Roboy/myo_shield/README.md

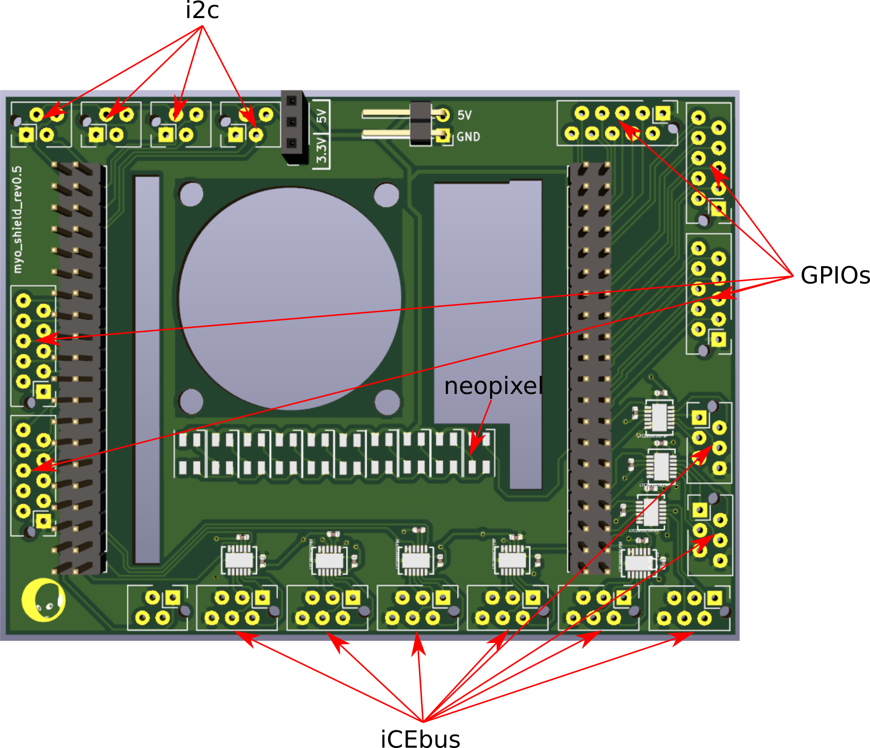
[picture p1: images/myo_shield.png]
myo_shield
