Roboy/myo_shield/myo_shield_pcb/myo_shield_pcb.kicad_pcb

## KiCad design myo_shield_pcb/myo_shield_pcb.kicad_pcb (2020-03-10)

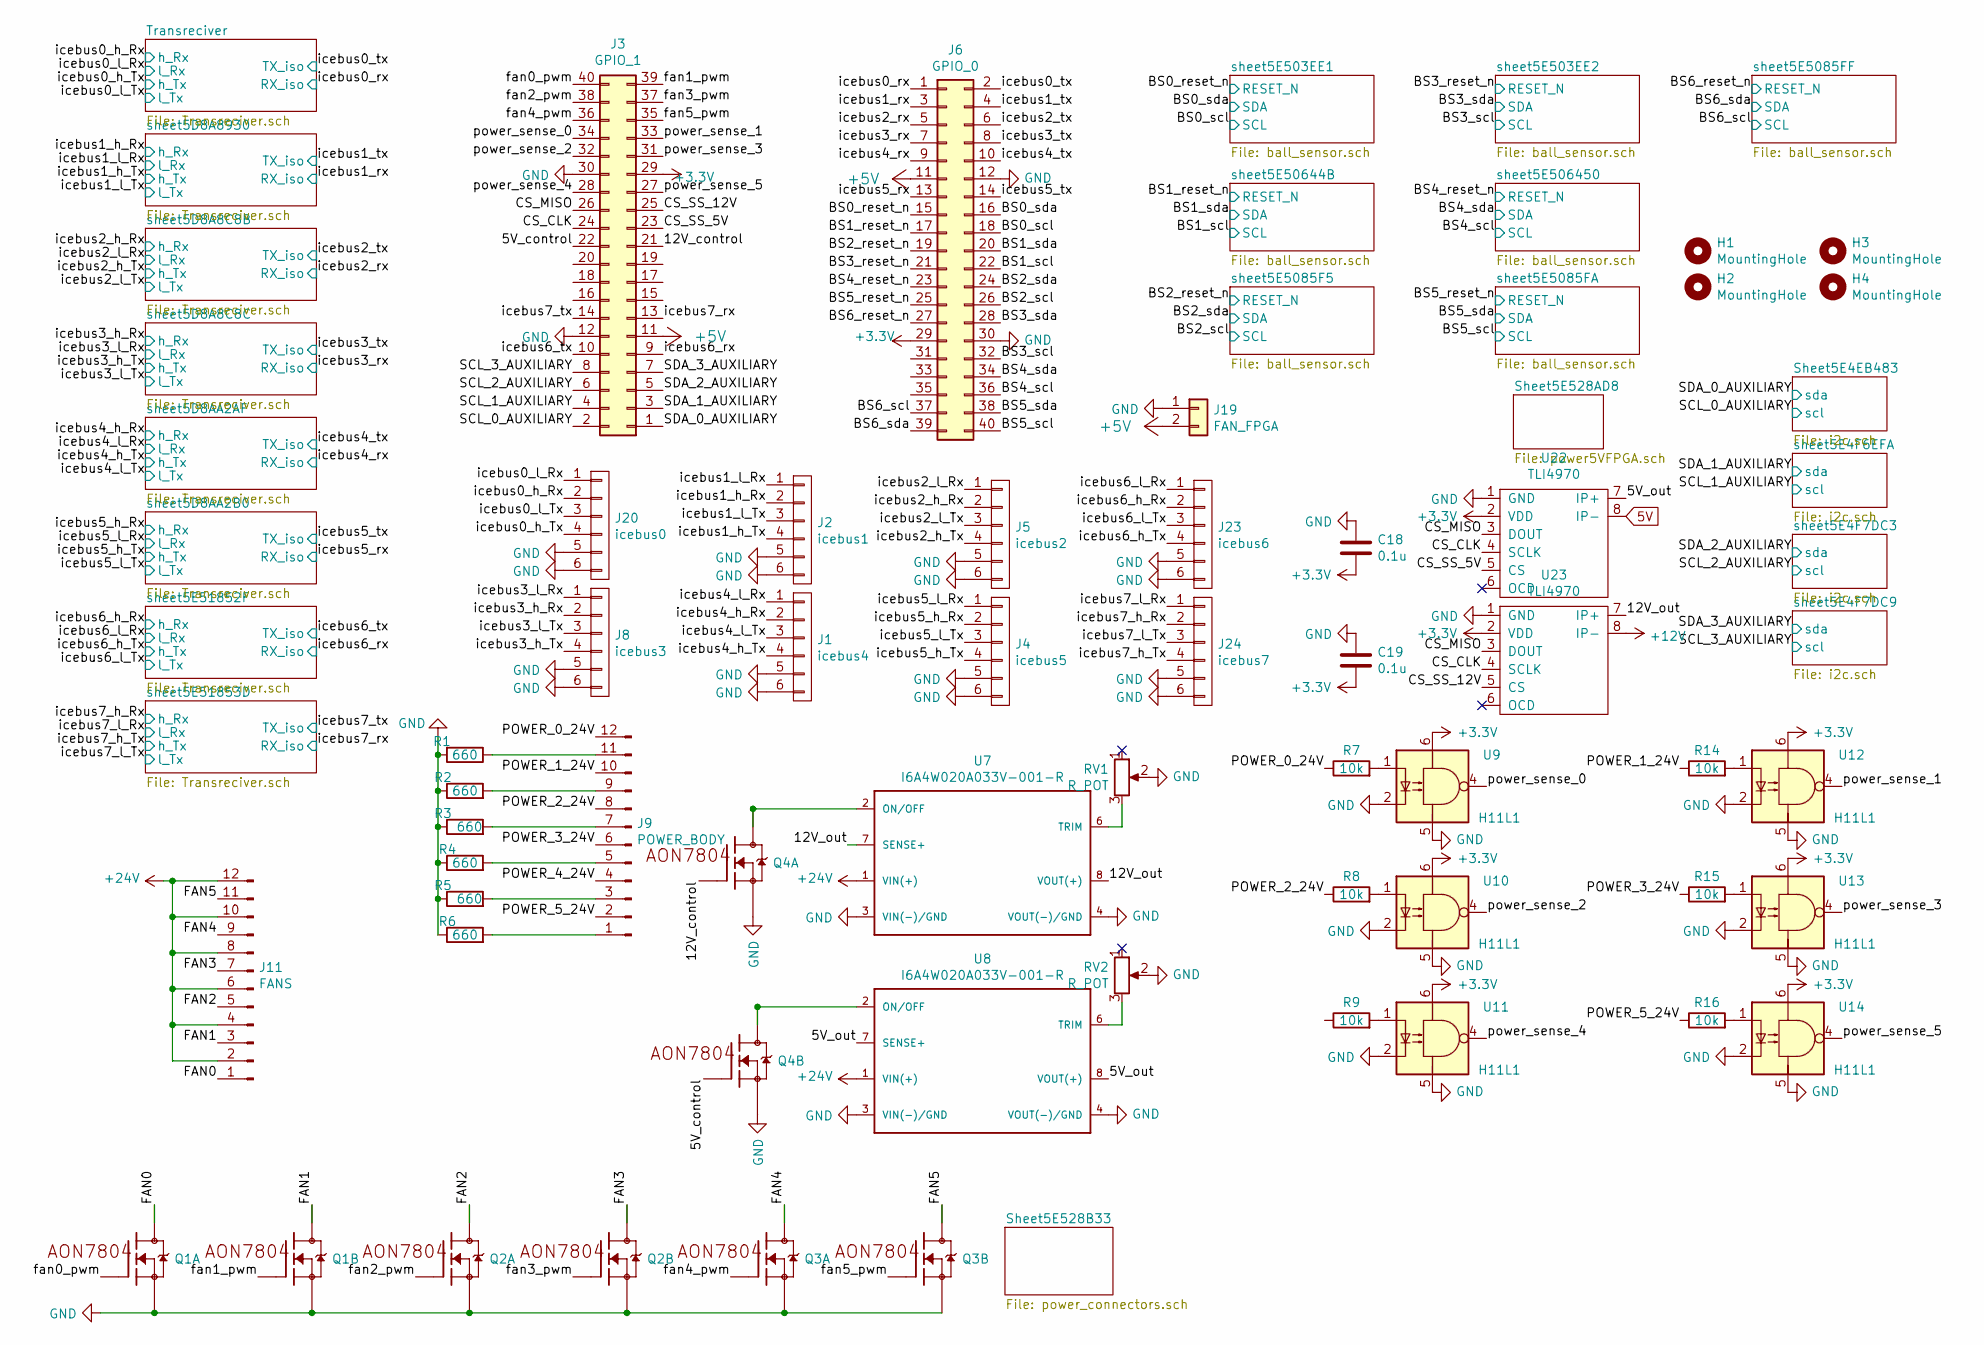
[picture p2: schematic myo_shield_pcb.sch]

Parts:
C18, C19: 0.1u; C_0402_1005Metric
H1, H2, H3, H4: MountingHole; MountingHole_3.2mm_M3
J1: icebus4; TE-Connectivity_Micro-Match_connector_02x03_Pitch_1.27mm
J2: icebus1; TE-Connectivity_Micro-Match_connector_02x03_Pitch_1.27mm
J3: GPIO_1; PinHeader_2x20_P2.54mm_Vertical
J4: icebus5; TE-Connectivity_Micro-Match_connector_02x03_Pitch_1.27mm
J5: icebus2; TE-Connectivity_Micro-Match_connector_02x03_Pitch_1.27mm
J6: GPIO_0; PinHeader_2x20_P2.54mm_Vertical
J8: icebus3; TE-Connectivity_Micro-Match_connector_02x03_Pitch_1.27mm
J9: POWER_BODY; PinHeader_2x06_P2.54mm_Vertical
J11: FANS; PinHeader_2x06_P2.54mm_Vertical
J19: FAN_FPGA; PinHeader_1x02_P2.54mm_Vertical
J20: icebus0; TE-Connectivity_Micro-Match_connector_02x03_Pitch_1.27mm
J23: icebus6; TE-Connectivity_Micro-Match_connector_02x03_Pitch_1.27mm
J24: icebus7; TE-Connectivity_Micro-Match_connector_02x03_Pitch_1.27mm
Q1, Q2, Q3, Q4: AON7804; DFN3X3
R1, R2, R3, R4, R5, R6: 660; R_0402_1005Metric
R7, R8, R9, R14, R15, R16: 10k; R_0402_1005Metric
RV1, RV2: R_POT; Potentiometer_Bourns_3214X_Vertical
U7, U8: I6A4W020A033V-001-R; TDK-LAMBDA_I6A4W020A033V-001-R
U9, U10, U11, U12, U13, U14: H11L1; DIL6-SMD
U22, U23: TLI4970

Connections:
5V: U22.8 (IP-); also elsewhere on the board
+3V3: C18.2, C19.2, J3.29, J6.29, U9.6, U10.6, U11.6, U12.6, U13.6, U14.6, U22.2 (VDD), U23.2 (VDD); also elsewhere on the board
+5V: J3.11, J6.11, J19.2; also elsewhere on the board
+12V: U23.8 (IP-); also elsewhere on the board
+24V: J11.2, J11.4, J11.6, J11.8, J11.10, J11.12, U7.1 (VIN(+)), U8.1 (VIN(+)); also elsewhere on the board
/5V_control: J3.22, Q4.G2 (G)
/5V_out: U8.7 (SENSE+), U8.8 (VOUT(+)), U22.7 (IP+)
/12V_control: J3.21, Q4.G1 (G)
/12V_out: U7.7 (SENSE+), U7.8 (VOUT(+)), U23.7 (IP+)
/BS0_reset_n: J6.15; also elsewhere on the board
/BS0_scl: J6.18; also elsewhere on the board
/BS0_sda: J6.16; also elsewhere on the board
/BS1_reset_n: J6.17; also elsewhere on the board
/BS1_scl: J6.22; also elsewhere on the board
/BS1_sda: J6.20; also elsewhere on the board
/BS2_reset_n: J6.19; also elsewhere on the board
/BS2_scl: J6.26; also elsewhere on the board
/BS2_sda: J6.24; also elsewhere on the board
/BS3_reset_n: J6.21; also elsewhere on the board
/BS3_scl: J6.32; also elsewhere on the board
/BS3_sda: J6.28; also elsewhere on the board
/BS4_reset_n: J6.23; also elsewhere on the board
/BS4_scl: J6.36; also elsewhere on the board
/BS4_sda: J6.34; also elsewhere on the board
/BS5_reset_n: J6.25; also elsewhere on the board
/BS5_scl: J6.40; also elsewhere on the board
/BS5_sda: J6.38; also elsewhere on the board
/BS6_reset_n: J6.27; also elsewhere on the board
/BS6_scl: J6.37; also elsewhere on the board
/BS6_sda: J6.39; also elsewhere on the board
/CS_CLK: J3.24, U22.4 (SCLK), U23.4 (SCLK)
/CS_MISO: J3.26, U22.3 (DOUT), U23.3 (DOUT)
/CS_SS_5V: J3.23, U22.5 (CS)
/CS_SS_12V: J3.25, U23.5 (CS)
/FAN0: J11.1, Q1.D1 (D), Q1.D1A (D1)
/FAN1: J11.3, Q1.D2 (D), Q1.D2A (D1)
/FAN2: J11.5, Q2.D1 (D), Q2.D1A (D1)
/FAN3: J11.7, Q2.D2 (D), Q2.D2A (D1)
/FAN4: J11.9, Q3.D1 (D), Q3.D1A (D1)
/FAN5: J11.11, Q3.D2 (D), Q3.D2A (D1)
/POWER_0_24V: J9.12, R7.1
/POWER_1_24V: J9.10, R14.1
/POWER_2_24V: J9.8, R8.1
/POWER_3_24V: J9.6, R15.1
/POWER_4_24V: J9.4
/POWER_5_24V: J9.2, R16.1
/SCL_0_AUXILIARY: J3.2; also elsewhere on the board
/SCL_1_AUXILIARY: J3.4; also elsewhere on the board
/SCL_2_AUXILIARY: J3.6; also elsewhere on the board
/SCL_3_AUXILIARY: J3.8; also elsewhere on the board
/SDA_0_AUXILIARY: J3.1; also elsewhere on the board
/SDA_1_AUXILIARY: J3.3; also elsewhere on the board
/SDA_2_AUXILIARY: J3.5; also elsewhere on the board
/SDA_3_AUXILIARY: J3.7; also elsewhere on the board
/fan0_pwm: J3.40, Q1.G1 (G)
/fan1_pwm: J3.39, Q1.G2 (G)
/fan2_pwm: J3.38, Q2.G1 (G)
/fan3_pwm: J3.37, Q2.G2 (G)
/fan4_pwm: J3.36, Q3.G1 (G)
/fan5_pwm: J3.35, Q3.G2 (G)
/icebus0_h_Rx: J20.2; also elsewhere on the board
/icebus0_h_Tx: J20.4; also elsewhere on the board
/icebus0_l_Rx: J20.1; also elsewhere on the board
/icebus0_l_Tx: J20.3; also elsewhere on the board
/icebus0_rx: J6.1; also elsewhere on the board
/icebus0_tx: J6.2; also elsewhere on the board
/icebus1_h_Rx: J2.2; also elsewhere on the board
/icebus1_h_Tx: J2.4; also elsewhere on the board
/icebus1_l_Rx: J2.1; also elsewhere on the board
/icebus1_l_Tx: J2.3; also elsewhere on the board
/icebus1_rx: J6.3; also elsewhere on the board
/icebus1_tx: J6.4; also elsewhere on the board
/icebus2_h_Rx: J5.2; also elsewhere on the board
/icebus2_h_Tx: J5.4; also elsewhere on the board
/icebus2_l_Rx: J5.1; also elsewhere on the board
/icebus2_l_Tx: J5.3; also elsewhere on the board
/icebus2_rx: J6.5; also elsewhere on the board
/icebus2_tx: J6.6; also elsewhere on the board
/icebus3_h_Rx: J8.2; also elsewhere on the board
/icebus3_h_Tx: J8.4; also elsewhere on the board
/icebus3_l_Rx: J8.1; also elsewhere on the board
/icebus3_l_Tx: J8.3; also elsewhere on the board
/icebus3_rx: J6.7; also elsewhere on the board
/icebus3_tx: J6.8; also elsewhere on the board
/icebus4_h_Rx: J1.2; also elsewhere on the board
/icebus4_h_Tx: J1.4; also elsewhere on the board
/icebus4_l_Rx: J1.1; also elsewhere on the board
/icebus4_l_Tx: J1.3; also elsewhere on the board
/icebus4_rx: J6.9; also elsewhere on the board
/icebus4_tx: J6.10; also elsewhere on the board
/icebus5_h_Rx: J4.2; also elsewhere on the board
/icebus5_h_Tx: J4.4; also elsewhere on the board
/icebus5_l_Rx: J4.1; also elsewhere on the board
/icebus5_l_Tx: J4.3; also elsewhere on the board
/icebus5_rx: J6.13; also elsewhere on the board
/icebus5_tx: J6.14; also elsewhere on the board
/icebus6_h_Rx: J23.2; also elsewhere on the board
/icebus6_h_Tx: J23.4; also elsewhere on the board
/icebus6_l_Rx: J23.1; also elsewhere on the board
/icebus6_l_Tx: J23.3; also elsewhere on the board
/icebus6_rx: J3.9; also elsewhere on the board
/icebus6_tx: J3.10; also elsewhere on the board
/icebus7_h_Rx: J24.2; also elsewhere on the board
/icebus7_h_Tx: J24.4; also elsewhere on the board
/icebus7_l_Rx: J24.1; also elsewhere on the board
/icebus7_l_Tx: J24.3; also elsewhere on the board
/icebus7_rx: J3.13; also elsewhere on the board
/icebus7_tx: J3.14; also elsewhere on the board
/power_sense_0: J3.34, U9.4
/power_sense_1: J3.33, U12.4
/power_sense_2: J3.32, U10.4
/power_sense_3: J3.31, U13.4
/power_sense_4: J3.28, U11.4
/power_sense_5: J3.27, U14.4
GND: C18.1, C19.1, J1.5, J1.6, J2.5, J2.6, J3.12, J3.30, J4.5, J4.6, J5.5, J5.6, J6.12, J6.30, J8.5, J8.6, J19.1, J20.5, J20.6, J23.5, J23.6, J24.5, J24.6, Q1.S1 (S), Q1.S2 (S), Q2.S1 (S), Q2.S2 (S), Q3.S1 (S), Q3.S2 (S), Q4.S1 (S), Q4.S2 (S), R1.2, R2.1, R3.1, R4.1, R5.1, R6.1, RV1.2, RV2.2, U7.3 (VIN(-)/GND), U7.4 (VOUT(-)/GND), U8.3 (VIN(-)/GND), U8.4 (VOUT(-)/GND), U9.2, U9.5, U10.2, U10.5, U11.2, U11.5, U12.2, U12.5, U13.2, U13.5, U14.2, U14.5, U22.1 (GND), U23.1 (GND); also elsewhere on the board
unnamed: J9.1, R6.2
unnamed: J9.3, R5.2
unnamed: J9.5, R4.2
unnamed: J9.7, R3.2
unnamed: J9.9, R2.2
unnamed: J9.11, R1.1
unnamed: Q4.D1 (D), Q4.D1A (D1), U7.2 (ON/OFF)
unnamed: Q4.D2 (D), Q4.D2A (D1), U8.2 (ON/OFF)
unnamed: R7.2, U9.1
unnamed: R8.2, U10.1
unnamed: R9.2, U11.1
unnamed: R14.2, U12.1
unnamed: R15.2, U13.1
unnamed: R16.2, U14.1
unnamed: RV1.3, U7.6 (TRIM)
unnamed: RV2.3, U8.6 (TRIM)

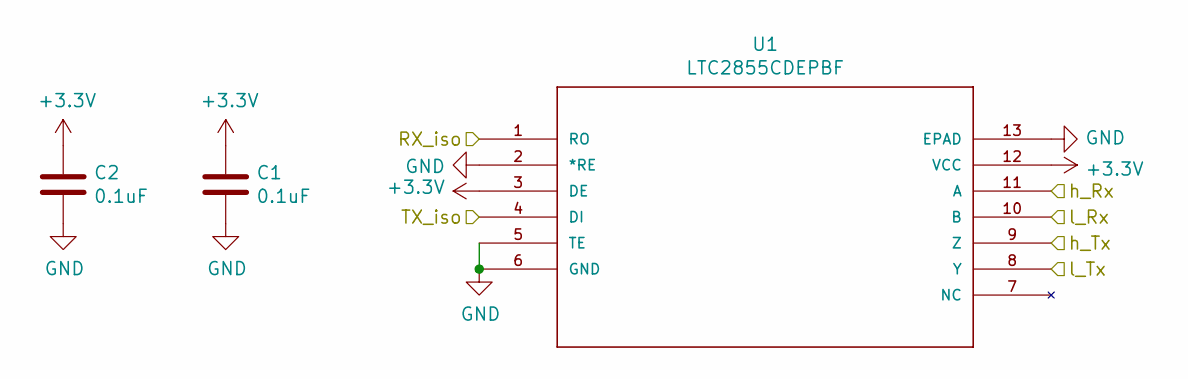
[picture p3: schematic Transreciver.sch]

Parts:
C1, C2: 0.1uF; C_0402_1005Metric
U1: LTC2855CDEPBF; ltc2855

Connections:
+3V3: C1.1, C2.1, U1.3 (DE), U1.12 (VCC); also elsewhere on the board
/icebus0_h_Rx: U1.11 (A); also elsewhere on the board
/icebus0_h_Tx: U1.9 (Z); also elsewhere on the board
/icebus0_l_Rx: U1.10 (B); also elsewhere on the board
/icebus0_l_Tx: U1.8 (Y); also elsewhere on the board
/icebus0_rx: U1.1 (RO); also elsewhere on the board
/icebus0_tx: U1.4 (DI); also elsewhere on the board
GND: C1.2, C2.2, U1.2 (*RE), U1.5 (TE), U1.6 (GND), U1.13 (EPAD); also elsewhere on the board

Parts of its further copies:
C3, C4, C5, C6, C7, C8, C9, C10, C11, C12, C20, C21, C22, C23, C24, C25, C26, C27: 0.1uF; C_0402_1005Metric
U2, U3, U4, U5, U6, U24, U25, U26, U27: LTC2855CDEPBF; ltc2855

Connections of its further copies:
+3V3: C3.1, C4.1, C5.1, C6.1, C7.1, C8.1, C9.1, C10.1, C11.1, C12.1, C20.1, C21.1, C22.1, C23.1, U2.3 (DE), U2.12 (VCC), U3.3 (DE), U3.12 (VCC), U4.3 (DE), U4.12 (VCC), U5.3 (DE), U5.12 (VCC), U6.3 (DE), U6.12 (VCC), U24.3 (DE), U24.12 (VCC), U25.3 (DE), U25.12 (VCC); also elsewhere on the board
/icebus1_h_Rx: U2.11 (A); also elsewhere on the board
/icebus1_h_Tx: U2.9 (Z); also elsewhere on the board
/icebus1_l_Rx: U2.10 (B); also elsewhere on the board
/icebus1_l_Tx: U2.8 (Y); also elsewhere on the board
/icebus1_rx: U2.1 (RO); also elsewhere on the board
/icebus1_tx: U2.4 (DI); also elsewhere on the board
/icebus2_h_Rx: U3.11 (A); also elsewhere on the board
/icebus2_h_Tx: U3.9 (Z); also elsewhere on the board
/icebus2_l_Rx: U3.10 (B); also elsewhere on the board
/icebus2_l_Tx: U3.8 (Y); also elsewhere on the board
/icebus2_rx: U3.1 (RO); also elsewhere on the board
/icebus2_tx: U3.4 (DI); also elsewhere on the board
/icebus3_h_Rx: U4.11 (A); also elsewhere on the board
/icebus3_h_Tx: U4.9 (Z); also elsewhere on the board
/icebus3_l_Rx: U4.10 (B); also elsewhere on the board
/icebus3_l_Tx: U4.8 (Y); also elsewhere on the board
/icebus3_rx: U4.1 (RO); also elsewhere on the board
/icebus3_tx: U4.4 (DI); also elsewhere on the board
/icebus4_h_Rx: U5.11 (A); also elsewhere on the board
/icebus4_h_Tx: U5.9 (Z); also elsewhere on the board
/icebus4_l_Rx: U5.10 (B); also elsewhere on the board
/icebus4_l_Tx: U5.8 (Y); also elsewhere on the board
/icebus4_rx: U5.1 (RO); also elsewhere on the board
/icebus4_tx: U5.4 (DI); also elsewhere on the board
/icebus5_h_Rx: U6.11 (A); also elsewhere on the board
/icebus5_h_Tx: U6.9 (Z); also elsewhere on the board
/icebus5_l_Rx: U6.10 (B); also elsewhere on the board
/icebus5_l_Tx: U6.8 (Y); also elsewhere on the board
/icebus5_rx: U6.1 (RO); also elsewhere on the board
/icebus5_tx: U6.4 (DI); also elsewhere on the board
/icebus6_h_Rx: U24.11 (A); also elsewhere on the board
/icebus6_h_Tx: U24.9 (Z); also elsewhere on the board
/icebus6_l_Rx: U24.10 (B); also elsewhere on the board
/icebus6_l_Tx: U24.8 (Y); also elsewhere on the board
/icebus6_rx: U24.1 (RO); also elsewhere on the board
/icebus6_tx: U24.4 (DI); also elsewhere on the board
/icebus7_h_Rx: U25.11 (A); also elsewhere on the board
/icebus7_h_Tx: U25.9 (Z); also elsewhere on the board
/icebus7_l_Rx: U25.10 (B); also elsewhere on the board
/icebus7_l_Tx: U25.8 (Y); also elsewhere on the board
/icebus7_rx: U25.1 (RO); also elsewhere on the board
/icebus7_tx: U25.4 (DI); also elsewhere on the board
GND: C3.2, C4.2, C5.2, C6.2, C7.2, C8.2, C9.2, C10.2, C11.2, C12.2, C20.2, C21.2, C22.2, C23.2, U2.2 (*RE), U2.5 (TE), U2.6 (GND), U2.13 (EPAD), U3.2 (*RE), U3.5 (TE), U3.6 (GND), U3.13 (EPAD), U4.2 (*RE), U4.5 (TE), U4.6 (GND), U4.13 (EPAD), U5.2 (*RE), U5.5 (TE), U5.6 (GND), U5.13 (EPAD), U6.2 (*RE), U6.5 (TE), U6.6 (GND), U6.13 (EPAD), U24.2 (*RE), U24.5 (TE), U24.6 (GND), U24.13 (EPAD), U25.2 (*RE), U25.5 (TE), U25.6 (GND), U25.13 (EPAD); also elsewhere on the board

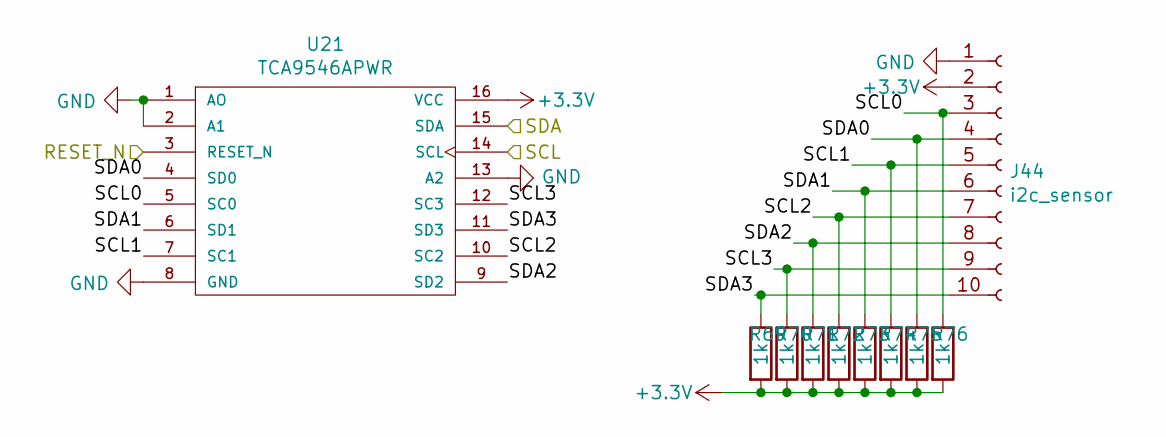
[picture p4: schematic ball_sensor.sch]

Parts:
J10: i2c_sensor; TE-Connectivity_Micro-Match_connector_02x05_Pitch_1.27mm
R21, R22, R23, R24, R25, R26, R27, R28: 1k; R_0402_1005Metric
U15: TCA9546APWR; SOP65P640X120-16N

Connections:
+3V3: J10.2, R21.2, R22.2, R23.2, R24.2, R25.2, R26.2, R27.2, R28.2, U15.16 (VCC); also elsewhere on the board
/BS0_reset_n: U15.3 (RESET_N); also elsewhere on the board
/BS0_scl: U15.14 (SCL); also elsewhere on the board
/BS0_sda: U15.15 (SDA); also elsewhere on the board
/sheet5E503EE1/SCL0: J10.3, R28.1, U15.5 (SC0)
/sheet5E503EE1/SCL1: J10.5, R26.1, U15.7 (SC1)
/sheet5E503EE1/SCL2: J10.7, R24.1, U15.10 (SC2)
/sheet5E503EE1/SCL3: J10.9, R22.1, U15.12 (SC3)
/sheet5E503EE1/SDA0: J10.4, R27.1, U15.4 (SD0)
/sheet5E503EE1/SDA1: J10.6, R25.1, U15.6 (SD1)
/sheet5E503EE1/SDA2: J10.8, R23.1, U15.9 (SD2)
/sheet5E503EE1/SDA3: J10.10, R21.1, U15.11 (SD3)
GND: J10.1, U15.1 (AO), U15.2 (A1), U15.8 (GND), U15.13 (A2); also elsewhere on the board

Parts of its further copies:
J12, J13, J14, J15, J43, J44: i2c_sensor; TE-Connectivity_Micro-Match_connector_02x05_Pitch_1.27mm
R29, R30, R31, R32, R33, R34, R35, R36, R37, R38, R39, R40, R41, R42, R43, R44, R45, R46, R47, R48, R49, R50, R51, R52, R53, R54, R55, R56, R57, R58, R59, R60, R61, R62, R63, R64, R65, R66, R67, R68, R69, R70, R71, R72, R73, R74, R75, R76: 1k; R_0402_1005Metric
U16, U17, U18, U19, U20, U21: TCA9546APWR; SOP65P640X120-16N

Connections of its further copies:
+3V3: J12.2, J13.2, J14.2, J15.2, J43.2, J44.2, R29.2, R30.2, R31.2, R32.2, R33.2, R34.2, R35.2, R36.2, R37.2, R38.2, R39.2, R40.2, R41.2, R42.2, R43.2, R44.2, R45.2, R46.2, R47.2, R48.2, R49.2, R50.2, R51.2, R52.2, R53.2, R54.2, R55.2, R56.2, R57.2, R58.2, R59.2, R60.2, R61.2, R62.2, R63.2, R64.2, R65.2, R66.2, R67.2, R68.2, R69.2, R70.2, R71.2, R72.2, R73.2, R74.2, R75.2, R76.2, U16.16 (VCC), U17.16 (VCC), U18.16 (VCC), U19.16 (VCC), U20.16 (VCC), U21.16 (VCC); also elsewhere on the board
/BS1_reset_n: U17.3 (RESET_N); also elsewhere on the board
/BS1_scl: U17.14 (SCL); also elsewhere on the board
/BS1_sda: U17.15 (SDA); also elsewhere on the board
/BS2_reset_n: U19.3 (RESET_N); also elsewhere on the board
/BS2_scl: U19.14 (SCL); also elsewhere on the board
/BS2_sda: U19.15 (SDA); also elsewhere on the board
/BS3_reset_n: U16.3 (RESET_N); also elsewhere on the board
/BS3_scl: U16.14 (SCL); also elsewhere on the board
/BS3_sda: U16.15 (SDA); also elsewhere on the board
/BS4_reset_n: U18.3 (RESET_N); also elsewhere on the board
/BS4_scl: U18.14 (SCL); also elsewhere on the board
/BS4_sda: U18.15 (SDA); also elsewhere on the board
/BS5_reset_n: U20.3 (RESET_N); also elsewhere on the board
/BS5_scl: U20.14 (SCL); also elsewhere on the board
/BS5_sda: U20.15 (SDA); also elsewhere on the board
/BS6_reset_n: U21.3 (RESET_N); also elsewhere on the board
/BS6_scl: U21.14 (SCL); also elsewhere on the board
/BS6_sda: U21.15 (SDA); also elsewhere on the board
/sheet5E503EE2/SCL0: J12.3, R36.1, U16.5 (SC0)
/sheet5E503EE2/SCL1: J12.5, R34.1, U16.7 (SC1)
/sheet5E503EE2/SCL2: J12.7, R32.1, U16.10 (SC2)
/sheet5E503EE2/SCL3: J12.9, R30.1, U16.12 (SC3)
/sheet5E503EE2/SDA0: J12.4, R35.1, U16.4 (SD0)
/sheet5E503EE2/SDA1: J12.6, R33.1, U16.6 (SD1)
/sheet5E503EE2/SDA2: J12.8, R31.1, U16.9 (SD2)
/sheet5E503EE2/SDA3: J12.10, R29.1, U16.11 (SD3)
/sheet5E5085F5/SCL0: J15.3, R60.1, U19.5 (SC0)
/sheet5E5085F5/SCL1: J15.5, R58.1, U19.7 (SC1)
/sheet5E5085F5/SCL2: J15.7, R56.1, U19.10 (SC2)
/sheet5E5085F5/SCL3: J15.9, R54.1, U19.12 (SC3)
/sheet5E5085F5/SDA0: J15.4, R59.1, U19.4 (SD0)
/sheet5E5085F5/SDA1: J15.6, R57.1, U19.6 (SD1)
/sheet5E5085F5/SDA2: J15.8, R55.1, U19.9 (SD2)
/sheet5E5085F5/SDA3: J15.10, R53.1, U19.11 (SD3)
/sheet5E5085FA/SCL0: J43.3, R68.1, U20.5 (SC0)
/sheet5E5085FA/SCL1: J43.5, R66.1, U20.7 (SC1)
/sheet5E5085FA/SCL2: J43.7, R64.1, U20.10 (SC2)
/sheet5E5085FA/SCL3: J43.9, R62.1, U20.12 (SC3)
/sheet5E5085FA/SDA0: J43.4, R67.1, U20.4 (SD0)
/sheet5E5085FA/SDA1: J43.6, R65.1, U20.6 (SD1)
/sheet5E5085FA/SDA2: J43.8, R63.1, U20.9 (SD2)
/sheet5E5085FA/SDA3: J43.10, R61.1, U20.11 (SD3)
/sheet5E5085FF/SCL0: J44.3, R76.1, U21.5 (SC0)
/sheet5E5085FF/SCL1: J44.5, R74.1, U21.7 (SC1)
/sheet5E5085FF/SCL2: J44.7, R72.1, U21.10 (SC2)
/sheet5E5085FF/SCL3: J44.9, R70.1, U21.12 (SC3)
/sheet5E5085FF/SDA0: J44.4, R75.1, U21.4 (SD0)
/sheet5E5085FF/SDA1: J44.6, R73.1, U21.6 (SD1)
/sheet5E5085FF/SDA2: J44.8, R71.1, U21.9 (SD2)
/sheet5E5085FF/SDA3: J44.10, R69.1, U21.11 (SD3)
/sheet5E50644B/SCL0: J13.3, R44.1, U17.5 (SC0)
/sheet5E50644B/SCL1: J13.5, R42.1, U17.7 (SC1)
/sheet5E50644B/SCL2: J13.7, R40.1, U17.10 (SC2)
/sheet5E50644B/SCL3: J13.9, R38.1, U17.12 (SC3)
/sheet5E50644B/SDA0: J13.4, R43.1, U17.4 (SD0)
/sheet5E50644B/SDA1: J13.6, R41.1, U17.6 (SD1)
/sheet5E50644B/SDA2: J13.8, R39.1, U17.9 (SD2)
/sheet5E50644B/SDA3: J13.10, R37.1, U17.11 (SD3)
/sheet5E506450/SCL0: J14.3, R52.1, U18.5 (SC0)
/sheet5E506450/SCL1: J14.5, R50.1, U18.7 (SC1)
/sheet5E506450/SCL2: J14.7, R48.1, U18.10 (SC2)
/sheet5E506450/SCL3: J14.9, R46.1, U18.12 (SC3)
/sheet5E506450/SDA0: J14.4, R51.1, U18.4 (SD0)
/sheet5E506450/SDA1: J14.6, R49.1, U18.6 (SD1)
/sheet5E506450/SDA2: J14.8, R47.1, U18.9 (SD2)
/sheet5E506450/SDA3: J14.10, R45.1, U18.11 (SD3)
GND: J12.1, J13.1, J14.1, J15.1, J43.1, J44.1, U16.1 (AO), U16.2 (A1), U16.8 (GND), U16.13 (A2), U17.1 (AO), U17.2 (A1), U17.8 (GND), U17.13 (A2), U18.1 (AO), U18.2 (A1), U18.8 (GND), U18.13 (A2), U19.1 (AO), U19.2 (A1), U19.8 (GND), U19.13 (A2), U20.1 (AO), U20.2 (A1), U20.8 (GND), U20.13 (A2), U21.1 (AO), U21.2 (A1), U21.8 (GND), U21.13 (A2); also elsewhere on the board

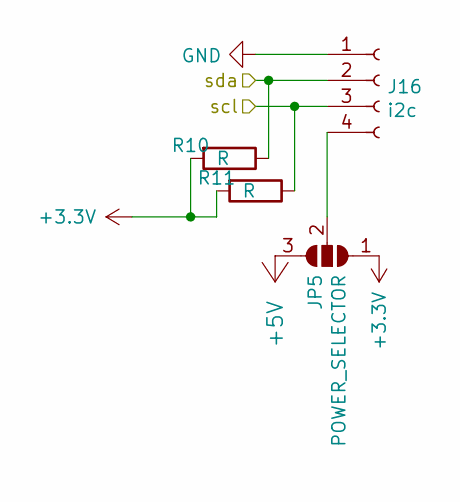
[picture p5: schematic i2c.sch]

Parts:
J16: i2c; TE-Connectivity_Micro-Match_connector_02x02_Pitch_1.27mm
JP5: POWER_SELECTOR; Solder_Bridge_3_0402
R10, R11: R; R_0402_1005Metric

Connections:
+3V3: JP5.1 (A), R10.2, R11.2; also elsewhere on the board
+5V: JP5.3 (B); also elsewhere on the board
/SCL_0_AUXILIARY: J16.3, R11.1; also elsewhere on the board
/SDA_0_AUXILIARY: J16.2, R10.1; also elsewhere on the board
GND: J16.1; also elsewhere on the board
unnamed: J16.4, JP5.2 (C)

Parts of its further copies:
J17, J18, J21: i2c; TE-Connectivity_Micro-Match_connector_02x02_Pitch_1.27mm
JP6, JP7, JP8: POWER_SELECTOR; Solder_Bridge_3_0402
R12, R13, R17, R18, R19, R20: R; R_0402_1005Metric

Connections of its further copies:
+3V3: JP6.1 (A), JP7.1 (A), JP8.1 (A), R12.2, R13.2, R17.2, R18.2, R19.2, R20.2; also elsewhere on the board
+5V: JP6.3 (B), JP7.3 (B), JP8.3 (B); also elsewhere on the board
/SCL_1_AUXILIARY: J17.3, R13.1; also elsewhere on the board
/SCL_2_AUXILIARY: J18.3, R18.1; also elsewhere on the board
/SCL_3_AUXILIARY: J21.3, R20.1; also elsewhere on the board
/SDA_1_AUXILIARY: J17.2, R12.1; also elsewhere on the board
/SDA_2_AUXILIARY: J18.2, R17.1; also elsewhere on the board
/SDA_3_AUXILIARY: J21.2, R19.1; also elsewhere on the board
GND: J17.1, J18.1, J21.1; also elsewhere on the board
unnamed: J17.4, JP6.2 (C)
unnamed: J18.4, JP7.2 (C)
unnamed: J21.4, JP8.2 (C)

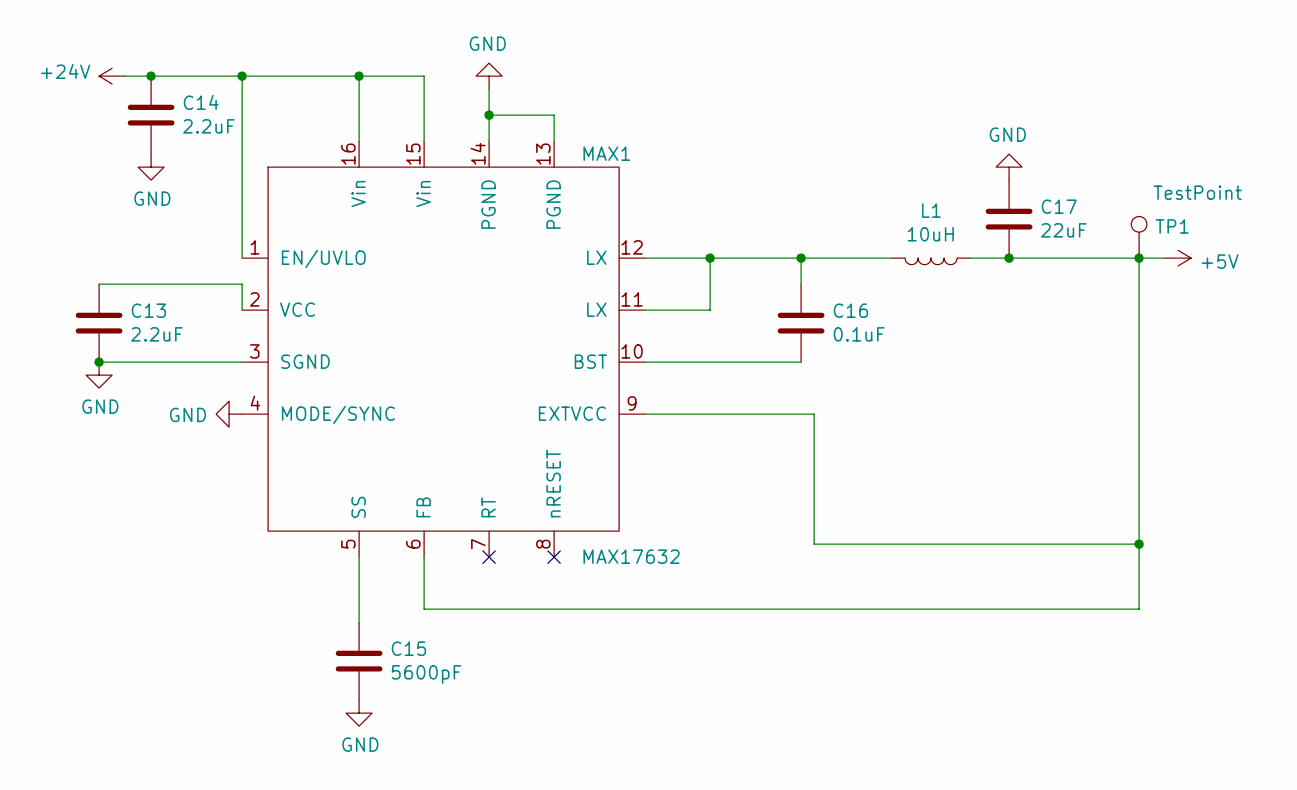
[picture p6: schematic power5VFPGA.sch]

Parts:
C13, C14: 2.2uF; C_0603_1608Metric
C15: 5600pF; C_0402_1005Metric
C16: 0.1uF; C_0402_1005Metric
C17: 22uF; C_0805_2012Metric
L1: 10uH; XAL5050-103MEC
MAX1: MAX17632; QFN-16-1EP_3x3mm_Pitch0.5mm
TP1: TestPoint; TestPoint_Pad_D1.0mm

Connections:
+5V: C17.2, L1.1, MAX1.6 (FB), MAX1.9 (EXTVCC), TP1.1; also elsewhere on the board
+24V: C14.1, MAX1.1 (EN/UVLO), MAX1.15 (Vin), MAX1.16 (Vin); also elsewhere on the board
GND: C13.2, C14.2, C15.2, C17.1, MAX1.3 (SGND), MAX1.4 (MODE/SYNC), MAX1.13 (PGND), MAX1.14 (PGND); also elsewhere on the board
unnamed: C13.1, MAX1.2 (VCC)
unnamed: C15.1, MAX1.5 (SS)
unnamed: C16.1, L1.2, MAX1.11 (LX), MAX1.12 (LX)
unnamed: C16.2, MAX1.10 (BST)

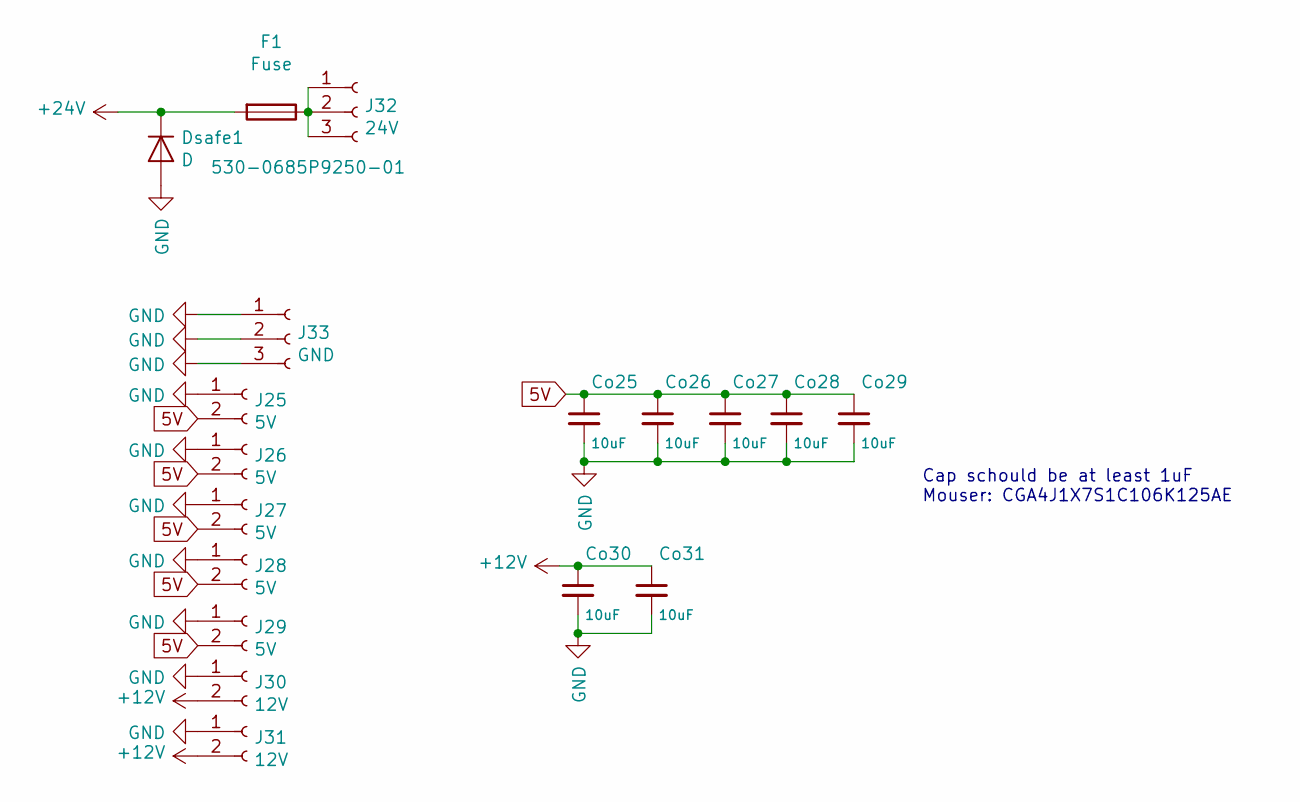
[picture p7: schematic power_connectors.sch]

Parts:
Co25, Co26, Co27, Co28, Co29, Co30, Co31: 10uF; C_0805_2012Metric_Pad1.15x1.40mm_HandSolder
Dsafe1: D; D_SMA
F1: Fuse; C_1206_3216Metric_Pad1.42x1.75mm_HandSolder; Mouser 530-0685P9250-01
J25, J26, J27, J28, J29: 5V; Wago_2060_2_SMD
J30, J31: 12V; Wago_2060_2_SMD
J32: 24V; Wago_2060_3_SMD
J33: GND; Wago_2060_3_SMD

Connections:
5V: Co25.1, Co26.1, Co27.1, Co28.1, Co29.1, J25.2, J26.2, J27.2, J28.2, J29.2; also elsewhere on the board
+12V: Co30.1, Co31.1, J30.2, J31.2; also elsewhere on the board
+24V: Dsafe1.1 (K), F1.2; also elsewhere on the board
GND: Co25.2, Co26.2, Co27.2, Co28.2, Co29.2, Co30.2, Co31.2, Dsafe1.2 (A), J25.1, J26.1, J27.1, J28.1, J29.1, J30.1, J31.1, J33.1, J33.2, J33.3; also elsewhere on the board
unnamed: F1.1, J32.1, J32.2, J32.3

Notes on the sheet:
Cap schould be at least 1uF Mouser: CGA4J1X7S1C106K125AE

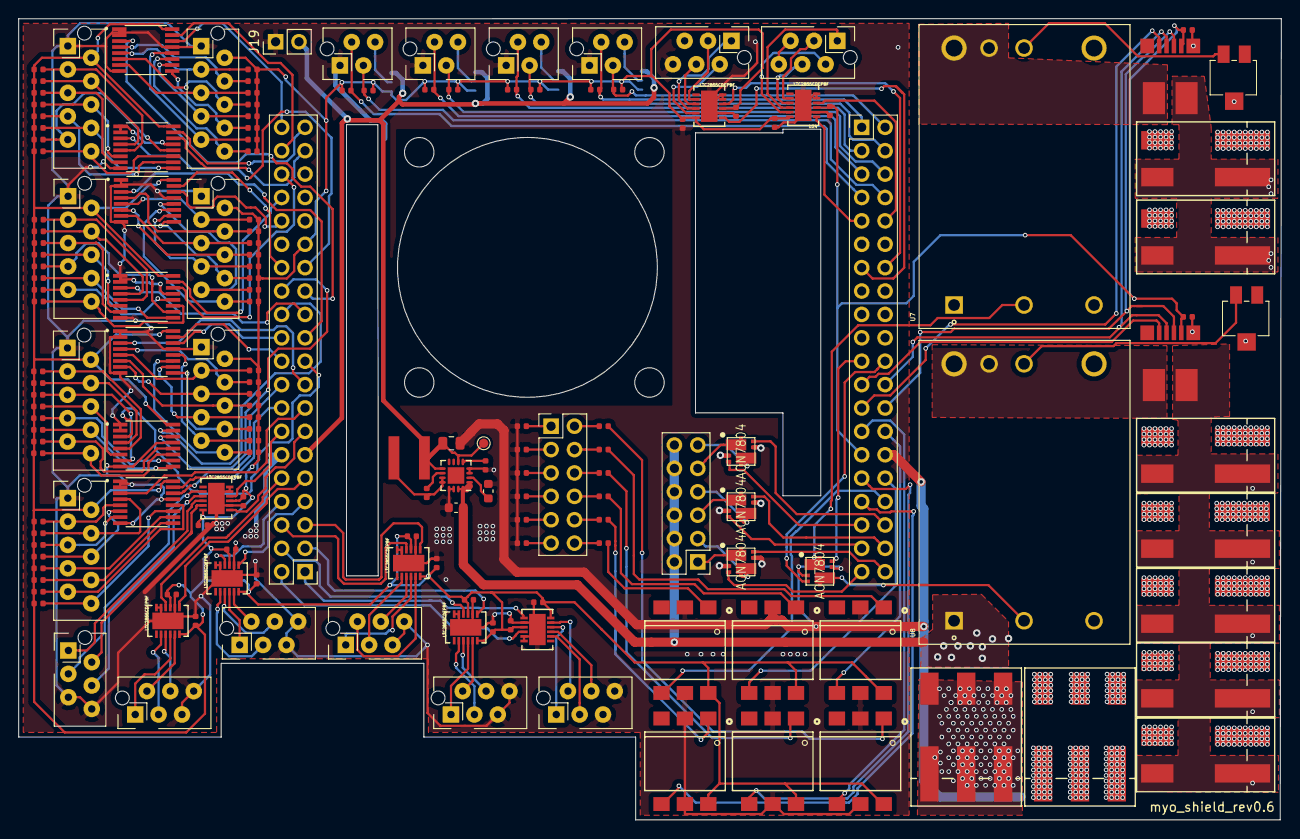
[picture p8: board myo_shield_pcb.kicad_pcb from above]

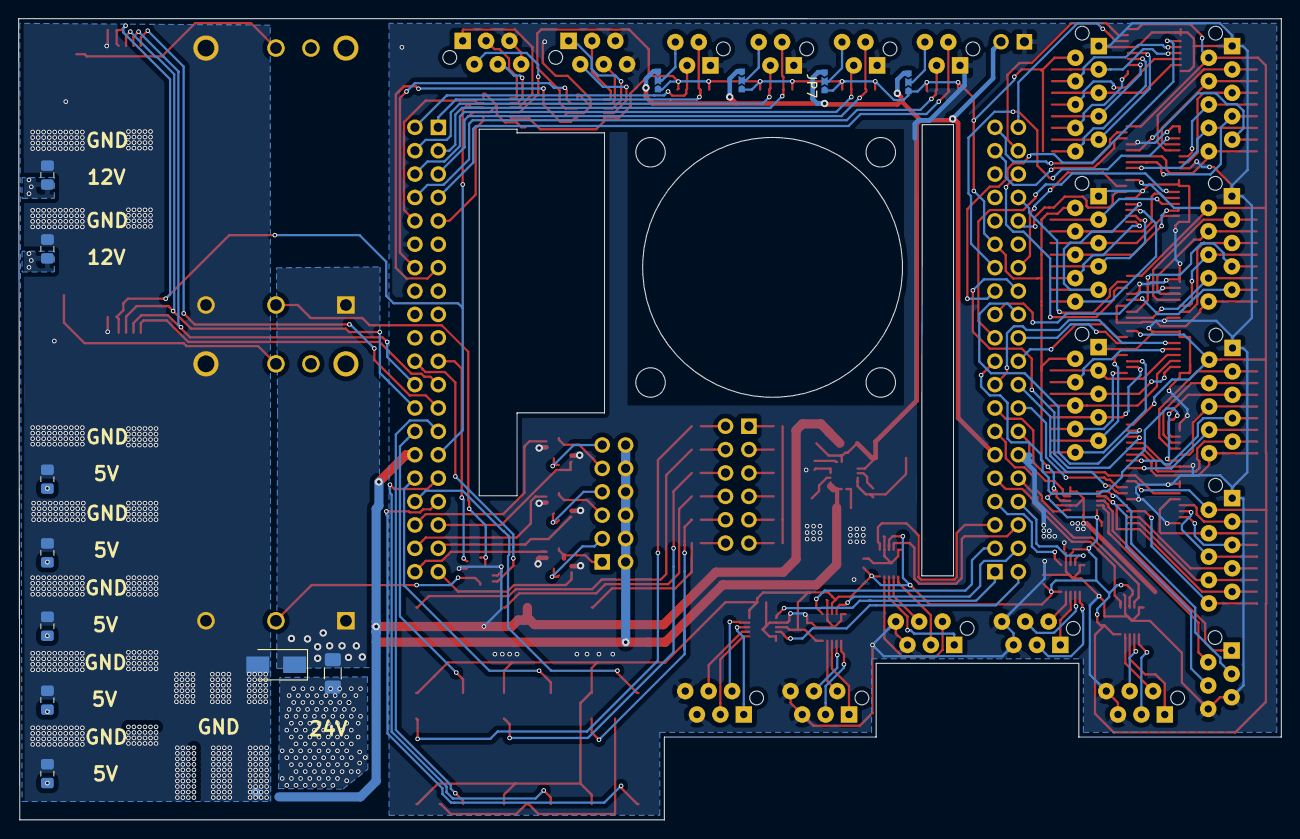
[picture p9: board myo_shield_pcb.kicad_pcb from below]

Board: 2 copper layers, 137.1 x 87.0 mm, 183 parts (13 on the bottom side), 195 nets.
