Roboy/myo_shield/(commit log)

2018-12-07 version 1
    [myo_shield_pcb.kicad_pcb, myo_shield_pcb.sch]
2018-12-07 with pcb
2018-12-28 fixed small GND connection
    [_saved_myo_shield_pcb.sch, myo_shield_pcb.kicad_pcb]
2019-02-02 rev 0.2
    [myo_shield_pcb.cfg, myo_shield_pcb.kicad_pcb, myo_shield_pcb1.FCStd]
2019-05-10 draft for spi bus protection
    [_saved_myo_shield_pcb.sch, myo_shield_pcb.kicad_pcb, myo_shield_pcb.sch]
2019-09-02 added RS485
    [Transreciver.sch, myo_shield_pcb.kicad_pcb]
2019-09-03 replaced 0402 footprint with the correct one, minor fixes
    [myo_shield_pcb-B_Cu.gbr, myo_shield_pcb-B_Mask.gbr, myo_shield_pcb-B_Paste.gbr, myo_shield_pcb-B_SilkS.gbr, myo_shield_pcb-Edge_Cuts.gbr, myo_shield_pcb-F_Cu.gbr, myo_shield_pcb-F_Mask.gbr, myo_shield_pcb-F_Paste.gbr]
2019-09-23 with ice and i2c buses
    [Transreciver.sch, myo_shield_pcb.sch]
2019-09-23 with icebus draft
    [myo_shield_pcb.kicad_pcb]
2019-09-25 with 8 icebus and dedicated connectors for 3d magnetic sensor rings
    [myo_shield_pcb-B.Cu.gbr, myo_shield_pcb-B.Mask.gbr, myo_shield_pcb-B.Paste.gbr, myo_shield_pcb-B.SilkS.gbr, myo_shield_pcb-B_Cu.gbr, myo_shield_pcb-B_Mask.gbr, myo_shield_pcb-B_Paste.gbr, myo_shield_pcb-Edge.Cuts.gbr]
2020-02-20 layout draft
    [Transreciver.sch, ball_sensor.sch, i2c.sch, myo_shield_pcb.kicad_pcb, myo_shield_pcb.sch, power5VFPGA.sch]
2020-02-20 layput almost done
    [Transreciver.sch, i2c.sch, myo_shield_pcb.kicad_pcb, power5VFPGA.sch]
2020-02-25 layout done
    [Transreciver.sch, i2c.sch, myo_shield_pcb.kicad_pcb, myo_shield_pcb.sch]
2020-03-05 added output Caps and input Fuse
    [Transreciver.sch, myo_shield_pcb.kicad_pcb, myo_shield_pcb.sch]
2020-03-05 with bom
    [BOM.csv, bottom_assembly.csv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]
2020-03-10 fix fan mosfet
    [BOM_all_parts.csv, BOM_pcbway.csv, Transreciver.sch, ball_sensor.sch, i2c.sch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]
